pohuo/diansai/empty/progress.md

# 进度日志

## 会话：2026-07-24

### 当前状态
- 阶段 1 重新定义为“灰度传感器基础读数 + 无线调试链路”。
- 用户明确希望优先使用蓝牙/串口调试，不再依赖 J-Link 做日常调试。
- 计划已切到“先读灰度、后接电机、最后 PID/陀螺仪”的顺序。

### 已完成
- 更新了 `task_plan.md`。
- 更新了 `findings.md`。
- 更新了 `progress.md`。
- 在规划层面明确了：5V 供电、共地、无线日志、灰度校准优先。

### 下一步
1. 确认蓝牙串口模块和波特率。
2. 确认灰度板 5V 供电和输出电平兼容。
3. 按原理图整理 4051 选通、ADC 输入和日志输出。
4. 开始做灰度原始值读取与校准代码。
## 会话：2026-07-25（DRV8701 驱动迁移）

### 已完成
- 基于最新 `main` 灰度工程，将 TB6612 四方向脚迁移为 DRV8701E 双路 `PH + EN(PWM)`。
- 固定引脚：左路 PB2/PA14，右路 PB3/PA16；PA13、PA17 释放。
- PWM 改为 20 kHz，新增 `drv8701.c/.h` 双路有符号速度接口。
- 上电默认解除使能；新增 ARM、手动 M、AUTO/GO、X/STOP/ESTOP 命令。
- 自动循迹使用现有 8 路灰度加权误差做基础 P 控制，未校准或丢线立即制动。
- 手动模式增加 1000 ms 命令看门狗，并新增架空联调说明。

### 线下待验收
1. 核对 LQ-DRV8701 控制插座丝印与 H12 接线。
2. 架空验证左右轮方向，必要时只调整软件极性或电机线其中一项。
3. 确认 20 kHz PWM 波形和 15%~20% 占空比起转情况。
4. 完成灰度 W/B 校准后再执行 AUTO。
