pohuo/diansai/empty/findings.md

# 发现与决策

## 当前需求
- 题目是“智能运球小车”，核心任务是让小车在赛道上自主往返、转向，并在后续支持更稳定的循迹与姿态控制。
- 现阶段优先级最高的是灰度传感器调试，不先做 PID，不先接电机闭环。

## 已确认的工程边界
- 调试方式改为蓝牙无线调试 + 串口日志。
- 不把 J-Link 作为日常交互入口，只保留必要时的烧录/恢复用途。
- 先不接 12V 电池和电机，避免再次引入电源冲击。
- 灰度模块单独用 5V 供电，MCU 仍用 3.3V。
- 所有相关地必须共地。

## 已知硬件方向
- 主控：MSPM0G3507
- 当前电机驱动：TB6612FNG
- 后续电机驱动：DRV8701
- 后续姿态模块：HWT101
- 显示模块：OLED 已安装
- 灰度模块：感为科技 8 路灰度板，内部使用 74HC4051 多路复用

## 当前判断
- 灰度调试的主要风险不是算法，而是供电、电平和安装高度。
- 先读到稳定的 8 路原始值，再谈黑线阈值和寻迹控制。
- 如果无线日志链路打通，后续无需频繁接电脑即可调试。

## 需要继续确认
- 蓝牙模块型号和串口参数
- 灰度模块输出是否直接兼容 3.3V
- 4051 选通引脚与当前原理图的最终对应关系
- OLED 的总线和占用引脚
- HWT101 的接口和波特率

## 本轮决策
1. 先做灰度传感器校准。
2. 先做串口/蓝牙日志，不上电机。
3. 先看原始值，不先做 PID。
4. 灰度板固定结构先解决，再谈稳定循迹。
