pohuo/diansai/empty/订单数据.xlsx

商品名称 | 型号款式 | 商品数量
小型圆形直流电磁铁吸盘机械手吸盘24V强磁起重工业电吸铁5V6V12V | 【DC5V】LS-P20/15 吸力3KG | 2
大夏龙雀BT04-E蓝牙模块SPP3.0+BLE4.2无线串口高速透传小尺寸 | BT08-E(T0)【双模 开发套件】拿样价 | 1
小型圆形直流电磁铁吸盘机械手吸盘24V强磁起重工业电吸铁5V6V12V | 【DC5V】LS-P20/15 吸力3KG | 2
联塑PPR水管家装4分20热熔6分25管道暖气热水接头自来水管材1米 | 【4分】20*3.4mm加厚 冷热通用管1米（双色） | 2
联塑PPR水管家装4分20热熔6分25管道暖气热水接头自来水管材1米 | 【4分】20*3.4mm加厚 冷热通用管1米（双色） | 1
G5轴承钢小钢球高精密钢珠Gcr15实心高精度滚珠粒弹珠0.5-15MM | 直径10mm【G5级高精密】20个 | 1
杜邦线 母对母 公对公 公对母10/15/20/30/40cm连接线40P彩色排线 | 杜邦线21CM 母对母 2.54mm（1排40P） | 1
R3X系列智能车底盘TI杯电赛阿克曼差速四驱麦轮宽15CM编码器电机 | R3X系列四轮两驱小车【顺丰当天发货】;不选配双路驱动模块;加高1层;13线霍尔编码器 | 1
联想读卡器sd卡高速usb3.0索尼佳能相机ccd手机电脑tf多合一通用行车记录仪内存卡转换器typec华为苹果15 | 【USB2.0盖帽款】支持SD/TF卡 | 1
ST-LINK V2 STM8/STM32仿真器编程器stlink下载器线烧录器调试器 | ST-LINK V2 仿真器 国产芯片软件可升级版本（颜色随机发） | 1
兼容J-link OB仿真下载调试器 SWD编程器jlink下载器代替V8 蓝色 | 兼容Jlink烧录器一套 | 1
5A大电流Type-C公转杜邦2.54公头带针2P连接线纯铜加粗两芯供电线 | 0.3m;2芯Type-C公转杜邦2.54母端 | 1
0.75平方加粗DC5.5一公三母电源线DC5.5通用一分三/四连接线0.7米 | 0.7m;DC5.5一公三母 | 1
DC5521公母头转杜邦2.54-2P主板供电转接3.5*1.35公头dc转杜邦母 | dc5.5*2.1公;2P分开;杜邦母;20CM | 1
12V母头线公头5.5*2.1连接线插头接头监控DC电源线24V dc一分二 | 5.5*2.1公头线纯铜芯DC电源线红黑12V24V 29cm 2条 | 1
兼容J-Link OB TYPE-C 仿真调试器 编程器 下载器 Jlink代v8 SWD | TYPE-C 接口 | 1
纯铜10A电源分接DC线LED监控12V通用一拖二三四五DC转接线5.5*2.1 | 一分三DC电源线-70CM | 1
5V 3.3V开关稳压模块电赛P03B短路过温反接保护降压工业级四层PCB | 【工业级四层板】带保护多功能5V/3.3V稳压模块P03B【多仓发货 大部分区域次日达】 | 1
R3系列两轮/三轮多用智能小车底盘直流步进减速电机测速巡线避障 | 【直流电机版】R3系列两轮/三轮多用智能小车底盘【顺丰包邮】 | 1
2自由度步进电机二维电动云台高精度编码器360度K230模块TI杯电赛 | 【含带编码器电机】步进电机版二维电动云台+双路步进电机驱动【顺丰包邮】 | 1
3C认证12V安全锂电池组TI杯电赛E351S可上飞机E326S智能车电源3S | 【带3C认证】12V 5100mAh+1.9A充电器+磁吸套装+线束包【多仓发货】 | 2
循迹模块四路红外寻迹巡线传感器4路识别高精度智能小车TI杯电赛 | LF04 四路红外巡线模块【多仓发货 大部分区域次日达】 | 1
STP-23L单点激光测距模块传感器高精度TOF测距原理毫米级串口输出 | STP-23L单点测距模块+串口转接模块【多仓发货 大部分区域次日达】 | 1
MP1584EN DC-DC可调降压模块12V24V5V 3A电源模块mini小体积航模 | MP1584EN可调电源降压模块 | 2
XH2.54双头单头蓝白排线2/3/4/5/6/8/10/12P电子连接线20/30/40cm | 6P公双头20cm（5条） | 1
杜邦线 母对母 公对公 公对母10/15/20/30/40cm连接线40P彩色排线 | 杜邦线21CM 母对母 2.54mm（1排40P） | 1
键盘模块 独立按键模块 4位独立按键模块 学生实验通用 | 4位直插独立按键模块焊排针向上 | 2
TB6612FNG电机驱动板模块 L298N直流电机驱动模块DRV8833电机驱动 | 高性能TB6612FNG电机驱动板【焊好排针】 | 1
MSPM0G3507系统板DAPLink开发板C07A单片机小车TI杯电子设计竞赛 | TI MSPM0G3507系统板（无OLED显示屏）【多仓发货 大部分区域次日达】 | 1
MSPM0G3507系统板DAPLink开发板C07A单片机小车TI杯电子设计竞赛 | TI MSPM0G3507模块化控制器（含OLED显示屏）+DAPLink下载器【多仓发货 大部分区域次日达】 | 1
无MCU八路灰度传感器 白黑红蓝绿线循迹模块 光电传感器 感为科技 | 红光款（排针焊接） | 1
Sipeed MaixCAM Pro AI开发板 NPU 视觉相机图像处理音频yolo电赛 | CAM Pro(含电池)[内置镜像卡] | 1
