pohuo/diansai/(commit log)

2026-07-25 Initial commit: Add project files
    [gray_sensor_mount.scad, 订单数据.xlsx]
2026-07-25 实现 DRV8701 双路驱动并接入灰度循迹
2026-07-25 加入八路灰度循迹模块
